brunogle/fuente-12v/3d_top.png

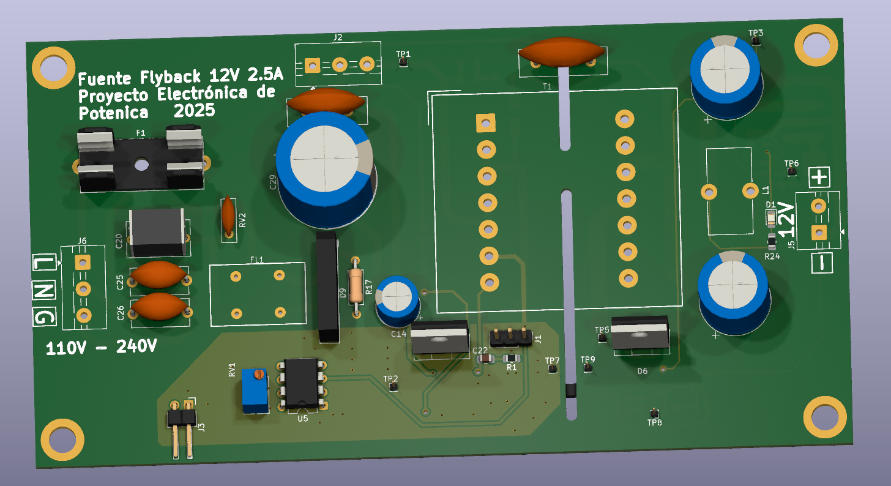
3d_top.png
