brunogle/fuente-12v/3d_bottom.png

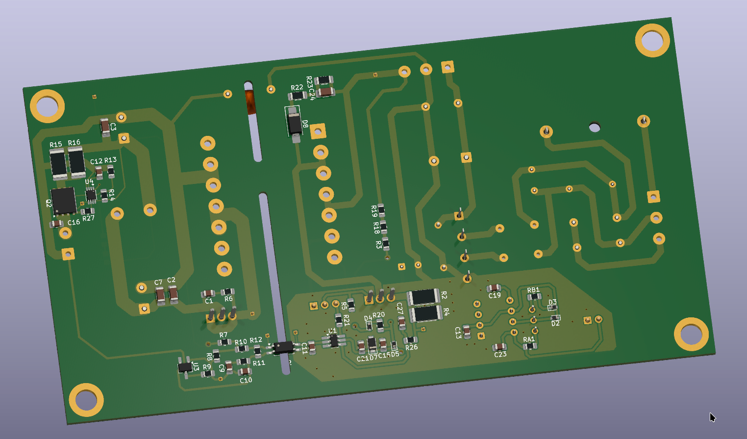
3d_bottom.png
