brunogle/fuente-12v/bottom.png

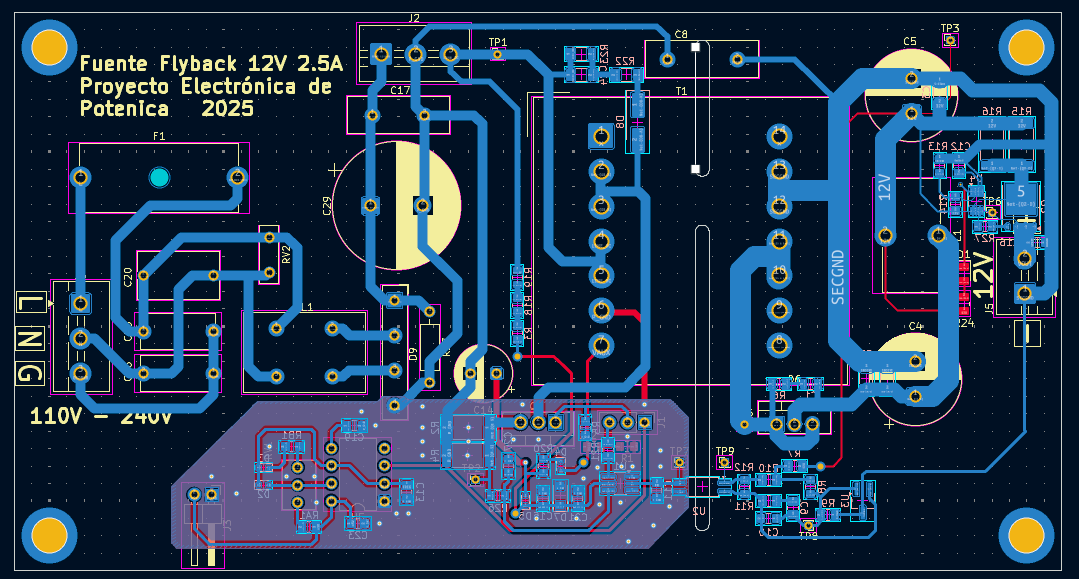
bottom.png
