brunogle/fuente-12v/fuente-12v.csv

Reference | Qty | Value | DNP | Exclude from BOM | Exclude from Board | Footprint | Datasheet | Description
C1,C9 | 2 | 680pF |  |  |  | Capacitor_SMD:C_0805_2012Metric_Pad1.18x1.45mm_HandSolder | ~
C2,C3,C7 | 3 | 4.7uF |  |  |  | Capacitor_SMD:C_1206_3216Metric_Pad1.33x1.80mm_HandSolder | ~
C4,C5 | 2 | 470u |  |  |  | Capacitor_THT:CP_Radial_D13.0mm_P5.00mm | ~ | FALTA DECIDIR
C8 | 1 | 1nF Y1 |  |  |  | Capacitor_THT:C_Disc_D16.0mm_W5.0mm_P10.00mm | ~ | https://www.mercadolibre.com.ar/x10-capacitor-ceramico-disco-supresor-1000pf-0001uf-x1-y1/up/MLAU278369151
C10 | 1 | 56pF |  |  |  | Capacitor_SMD:C_0805_2012Metric_Pad1.18x1.45mm_HandSolder | ~
C11 | 1 | 1nF |  |  |  | Capacitor_SMD:C_0805_2012Metric_Pad1.18x1.45mm_HandSolder | ~
C12 | 1 | 56nF |  |  |  | Capacitor_SMD:C_0805_2012Metric_Pad1.18x1.45mm_HandSolder | ~
C13,C19 | 2 | 10n |  |  |  | Capacitor_SMD:C_0805_2012Metric_Pad1.18x1.45mm_HandSolder | ~
C14 | 1 | 100uF |  |  |  | Capacitor_THT:CP_Radial_D8.0mm_P3.80mm | ~ | https://www.mercadolibre.com.ar/10-capacitores-electroliticos-100uf-x-35v-105-8x12mm/up/MLAU127441689
C15 | 1 | 4.7uF 50V |  |  |  | Capacitor_SMD:C_0805_2012Metric_Pad1.18x1.45mm_HandSolder | ~
C16 | 1 | 470nF |  |  |  | Capacitor_SMD:C_0805_2012Metric_Pad1.18x1.45mm_HandSolder | ~
C17 | 1 | 470nF 400V |  |  |  | Capacitor_THT:C_Disc_D14.5mm_W5.0mm_P7.50mm | ~
C20 | 1 | 33nF X2 |  |  |  | Capacitor_THT:C_Rect_L11.5mm_W6.6mm_P10.00mm_MKT | ~ | Bruno tiene
C21,C23 | 2 | 100nF |  |  |  | Capacitor_SMD:C_0805_2012Metric_Pad1.18x1.45mm_HandSolder | ~
C22 | 1 | 470pF |  |  |  | Capacitor_SMD:C_0805_2012Metric_Pad1.18x1.45mm_HandSolder | ~
C24 | 1 | 10nF |  |  |  | Capacitor_SMD:C_1206_3216Metric_Pad1.33x1.80mm_HandSolder | ~
C25,C26 | 2 | 1nF Y1 |  |  |  | Capacitor_THT:C_Disc_D10.5mm_W5.0mm_P10.00mm | ~ | https://www.mercadolibre.com.ar/x10-capacitor-ceramico-disco-supresor-1000pf-0001uf-x1-y1/up/MLAU278369151
C27 | 1 | 22pF 50V |  |  |  | Capacitor_SMD:C_0805_2012Metric_Pad1.18x1.45mm_HandSolder | ~
C29 | 1 | 150uF 400V |  |  |  | Capacitor_THT:CP_Radial_D18.0mm_P7.50mm | ~ | Bruno tiene uno solo
D2,D3,D4,D5 | 4 | 1N4148WT |  |  |  | Diode_SMD:D_SOD-523 | https://www.diodes.com/assets/Datasheets/ds30396.pdf | https://www.mercadolibre.com.ar/x10-1n4148ws-sod323-1n4148-ws-w2-smd-diodo/up/MLAU3429642478
D6 | 1 | MBR20200CT |  |  |  | Package_TO_SOT_THT:TO-220-3_Vertical | ~ | https://www.mercadolibre.com.ar/diodo-mbr20200ct-mbr20200-schottky-doble-20a-200v-to220/up/MLAU263325914
D7 | 1 | Bzt52c20 |  |  |  | Diode_SMD:Nexperia_CFP3_SOD-123W | ~ | https://www.mercadolibre.com.ar/bzt52c20-bzt-52c20-wm-diodo-zener-20-v-05w-sod-123-x-5-unid/p/MLA2042479519
D8 | 1 | ES1J |  |  |  | Diode_SMD:D_SMA_Handsoldering | ~ | https://www.mercadolibre.com.ar/kit-x50-es1j-diodo-fast-rapido-smd-1a-600v-35ns-uf4007/p/MLA2042186244
D9 | 1 | KBL10 |  |  |  | Diode_THT:Diode_Bridge_19.0x3.5x10.0mm_P5.0mm | ~ | https://www.sycelectronica.com.ar/articulo.php?codigo=KBL10
F1 | 1 | 1A 20mm |  |  |  | Fuse:Fuseholder_Cylinder-5x20mm_Schurter_0031_8201_Horizontal_Open | ~ | https://www.sycelectronica.com.ar/pasivos/PF-CUNA-20.pdf
FL1 | 1 | ST-110BH |  |  |  | fuente-12v:ST-110 | ~ | https://www.microelectronicash.com/filtro-linea--det--FILTRO-LINEA
J1 | 1 | Conn_01x03_Pin |  |  |  | Connector_PinHeader_2.54mm:PinHeader_1x03_P2.54mm_Vertical | ~
J2 | 1 | Screw_Terminal_01x03 |  |  |  | TerminalBlock:TerminalBlock_MaiXu_MX126-5.0-03P_1x03_P5.00mm | ~ | Screw_Terminal_01x03 P5mm
J3 | 1 | Conn_01x02_Pin |  |  |  | Connector_PinHeader_2.54mm:PinHeader_1x02_P2.54mm_Horizontal | ~
J5 | 1 | OUTPUT |  |  |  | TerminalBlock:TerminalBlock_MaiXu_MX126-5.0-02P_1x02_P5.00mm | ~ | Screw_Terminal_01x02 P5mm
J6 | 1 | Screw_Terminal_01x03 P5mm |  |  |  | TerminalBlock:TerminalBlock_MaiXu_MX126-5.0-03P_1x03_P5.00mm | ~ | Screw_Terminal_01x03 P5mm
L1 | 1 | 10uH 3A |  |  |  | Inductor_THT:L_Toroid_Vertical_L16.0mm_W8.0mm_P7.62mm | ~ | FALTA DECIDIR
Q1 | 1 | IPP65R190C7 |  |  |  | Package_TO_SOT_THT:TO-220-3_Vertical | ~ | Tenemos
Q2 | 1 | CSD16403Q5A |  |  |  | Package_TO_SOT_SMD:TDSON-8-1 | http://www.ti.com/lit/gpn/csd16403q5a | Tenemos
R1,R20,R21,R27 | 4 | 10 |  |  |  | Resistor_SMD:R_0805_2012Metric_Pad1.20x1.40mm_HandSolder | ~
R2,R4 | 2 | 0.47 |  |  |  | Resistor_SMD:R_2512_6332Metric_Pad1.40x3.35mm_HandSolder | ~ | https://www.dicomse.com.ar/
R3,R18,R19 | 3 | 2M |  |  |  | Resistor_SMD:R_0805_2012Metric_Pad1.20x1.40mm_HandSolder | ~
R5,R14,R26 | 3 | 10k |  |  |  | Resistor_SMD:R_0805_2012Metric_Pad1.20x1.40mm_HandSolder | ~
R6 | 1 | 100 |  |  |  | Resistor_SMD:R_0805_2012Metric_Pad1.20x1.40mm_HandSolder | ~
R7 | 1 | 51 |  |  |  | Resistor_SMD:R_0805_2012Metric_Pad1.20x1.40mm_HandSolder | ~
R8 | 1 | 86.6k |  |  |  | Resistor_SMD:R_0805_2012Metric_Pad1.20x1.40mm_HandSolder | ~
R9 | 1 | 23.4k |  |  |  | Resistor_SMD:R_0805_2012Metric_Pad1.20x1.40mm_HandSolder | ~
R10 | 1 | 5k |  |  |  | Resistor_SMD:R_0805_2012Metric_Pad1.20x1.40mm_HandSolder | ~ | Resistor
R11 | 1 | 133k |  |  |  | Resistor_SMD:R_0805_2012Metric_Pad1.20x1.40mm_HandSolder | ~
R12 | 1 | 2.49k |  |  |  | Resistor_SMD:R_0805_2012Metric_Pad1.20x1.40mm_HandSolder | ~
R13 | 1 | 120k |  |  |  | Resistor_SMD:R_0805_2012Metric_Pad1.20x1.40mm_HandSolder | ~
R15,R16 | 2 | 1 |  |  |  | Resistor_SMD:R_2512_6332Metric_Pad1.40x3.35mm_HandSolder | ~ | https://www.dicomse.com.ar/
R17 | 1 | 1M |  |  |  | Resistor_THT:R_Axial_DIN0207_L6.3mm_D2.5mm_P10.16mm_Horizontal | ~
R22 | 1 | 22 |  |  |  | Resistor_SMD:R_1206_3216Metric_Pad1.30x1.75mm_HandSolder | ~
R23 | 1 | 80k |  |  |  | Resistor_SMD:R_1206_3216Metric_Pad1.30x1.75mm_HandSolder | ~
RA1,RB1 | 2 | 220 |  |  |  | Resistor_SMD:R_0805_2012Metric_Pad1.20x1.40mm_HandSolder | ~
RV1 | 1 | 1k |  |  |  | Potentiometer_THT:Potentiometer_Bourns_3266Y_Vertical | ~
RV2 | 1 | Varistor |  |  |  | Capacitor_THT:C_Disc_D8.0mm_W2.5mm_P5.00mm | ~ | Bruno tiene
T1 | 1 | ~ |  |  |  | fuente-12v:750811744 | https://www.we-online.com/components/products/datasheet/750811744.pdf | Tenemos
TP1,TP2,TP3,TP5,TP6,TP7,TP8,TP9 | 8 | TestPoint |  |  |  | Connector_PinHeader_1.00mm:PinHeader_1x01_P1.00mm_Vertical | ~ | test point
U1 | 1 | UCC287501D |  |  |  | Package_TO_SOT_SMD:TSOT-23-6_HandSoldering | https://www.ti.com/lit/ds/symlink/ucc28750.pdf | Tenemos
U2 | 1 | TCMT1107 |  |  |  | Package_SO:SOP-4_4.4x2.6mm_P1.27mm | http://www.vishay.com/docs/83510/tcmt1100.pdf | Tenemos
U3 | 1 | TL432DBZ |  |  |  | Package_TO_SOT_SMD:SOT-23W_Handsoldering | http://www.ti.com/lit/ds/symlink/tl431.pdf | Tenemos
U4 | 1 | TPS24701DGKR |  |  |  | Package_SO:VSSOP-8_2.3x2mm_P0.5mm | https://www.ti.com/lit/ds/symlink/ucc28750.pdf | Tenemos
U5 | 1 | NE555P |  |  |  | Package_DIP:DIP-8_W7.62mm | http://www.ti.com/lit/ds/symlink/ne555.pdf
