brunogle/fuente-12v/fuente-12v-schematics.pdf

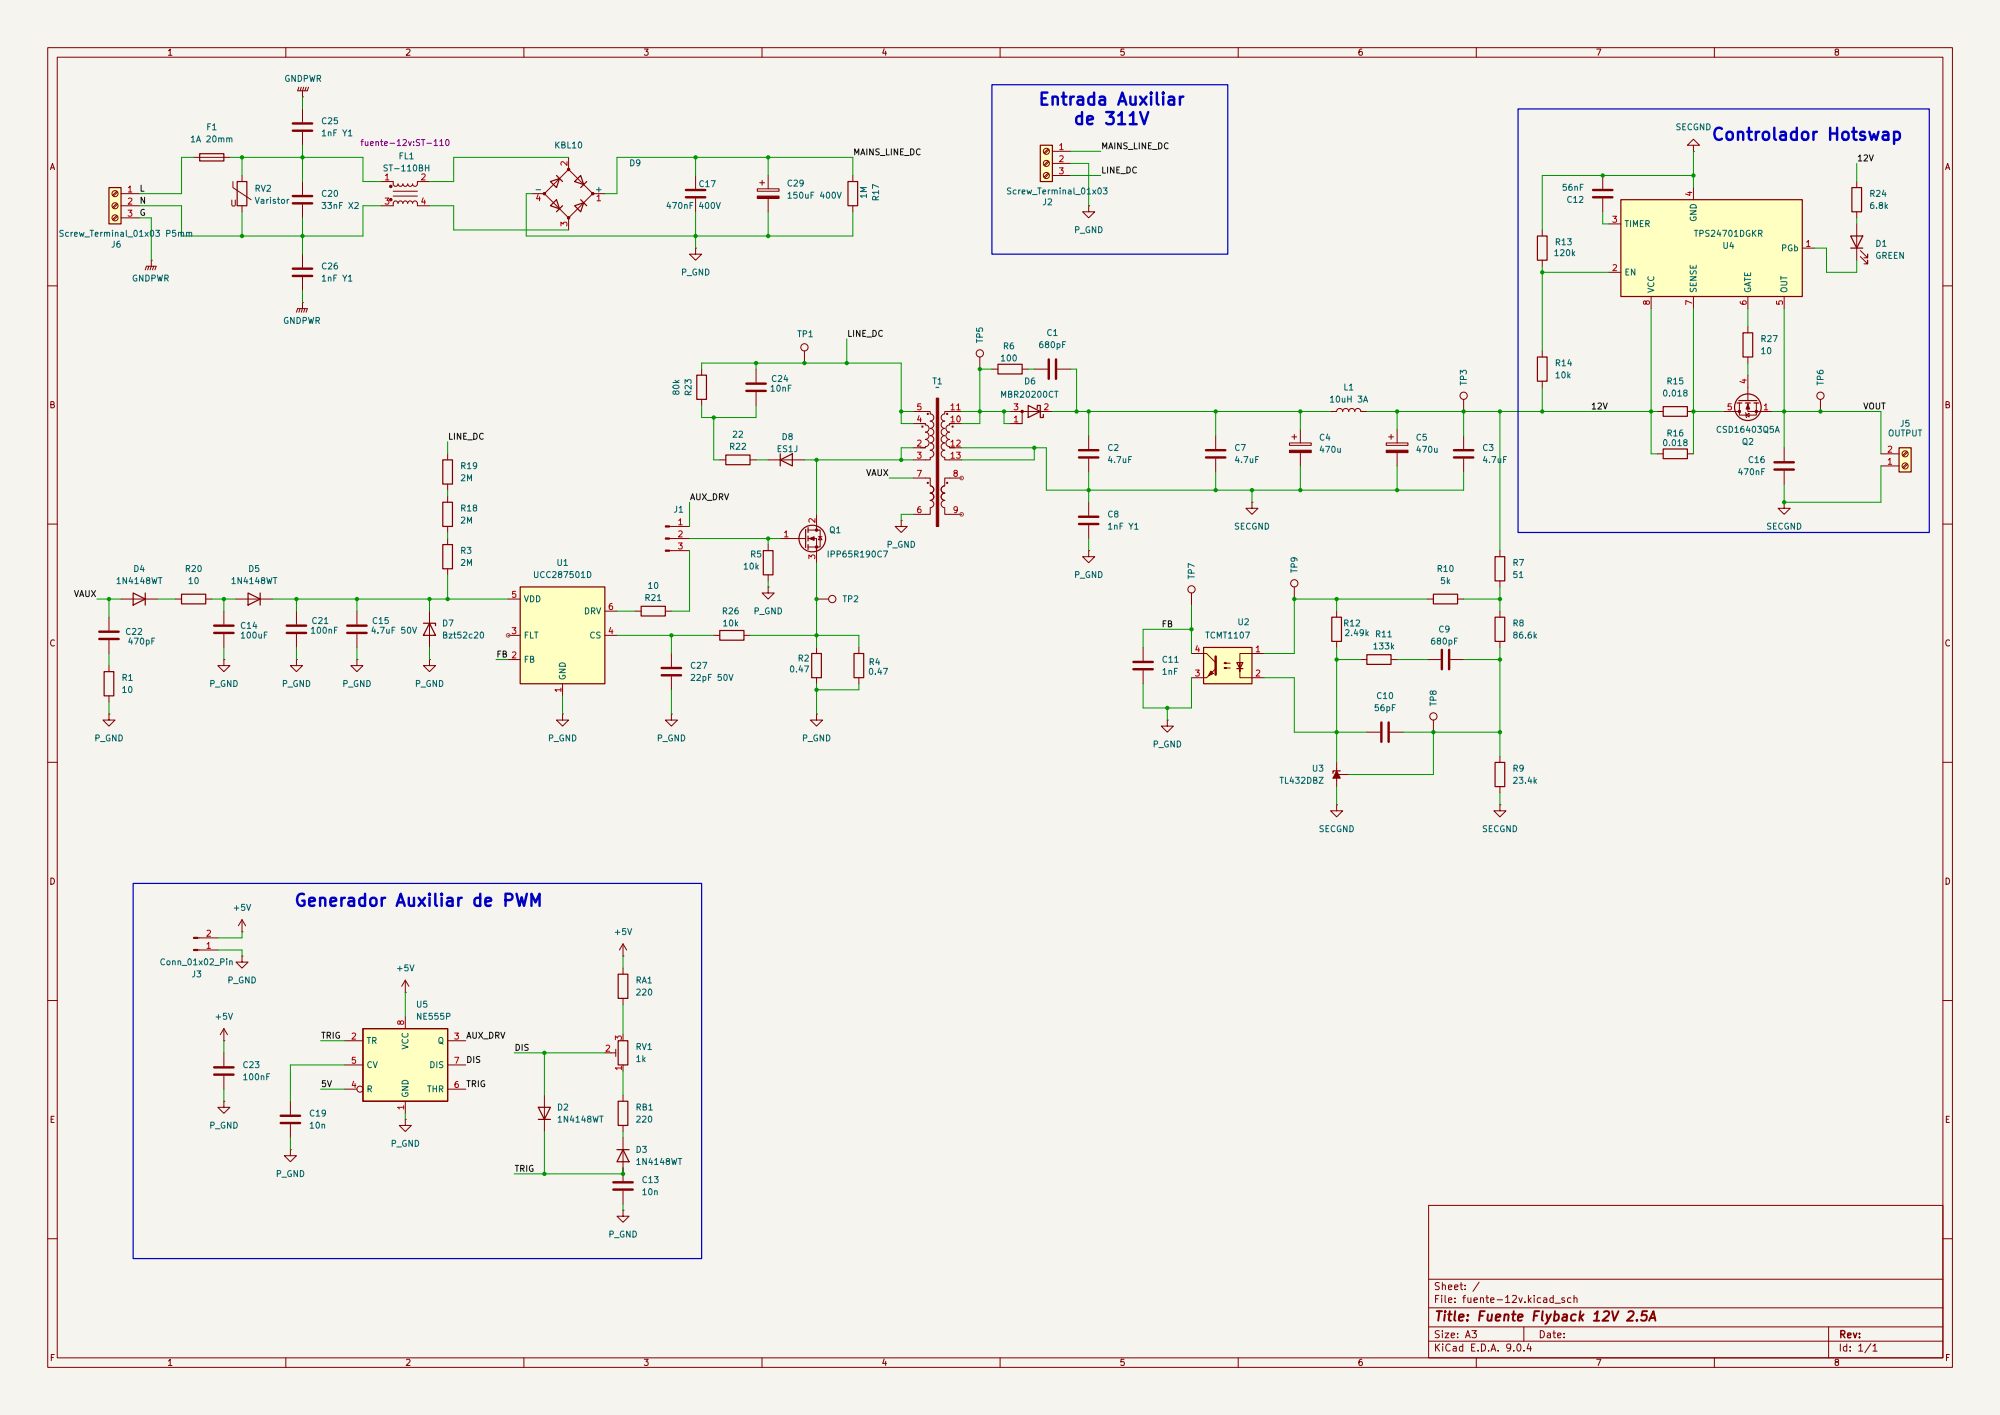
[picture p4: page 1]
