brunogle/fuente-12v/fuente-12v.kicad_pcb

## KiCad design fuente-12v.kicad_pcb (2025-10-09)

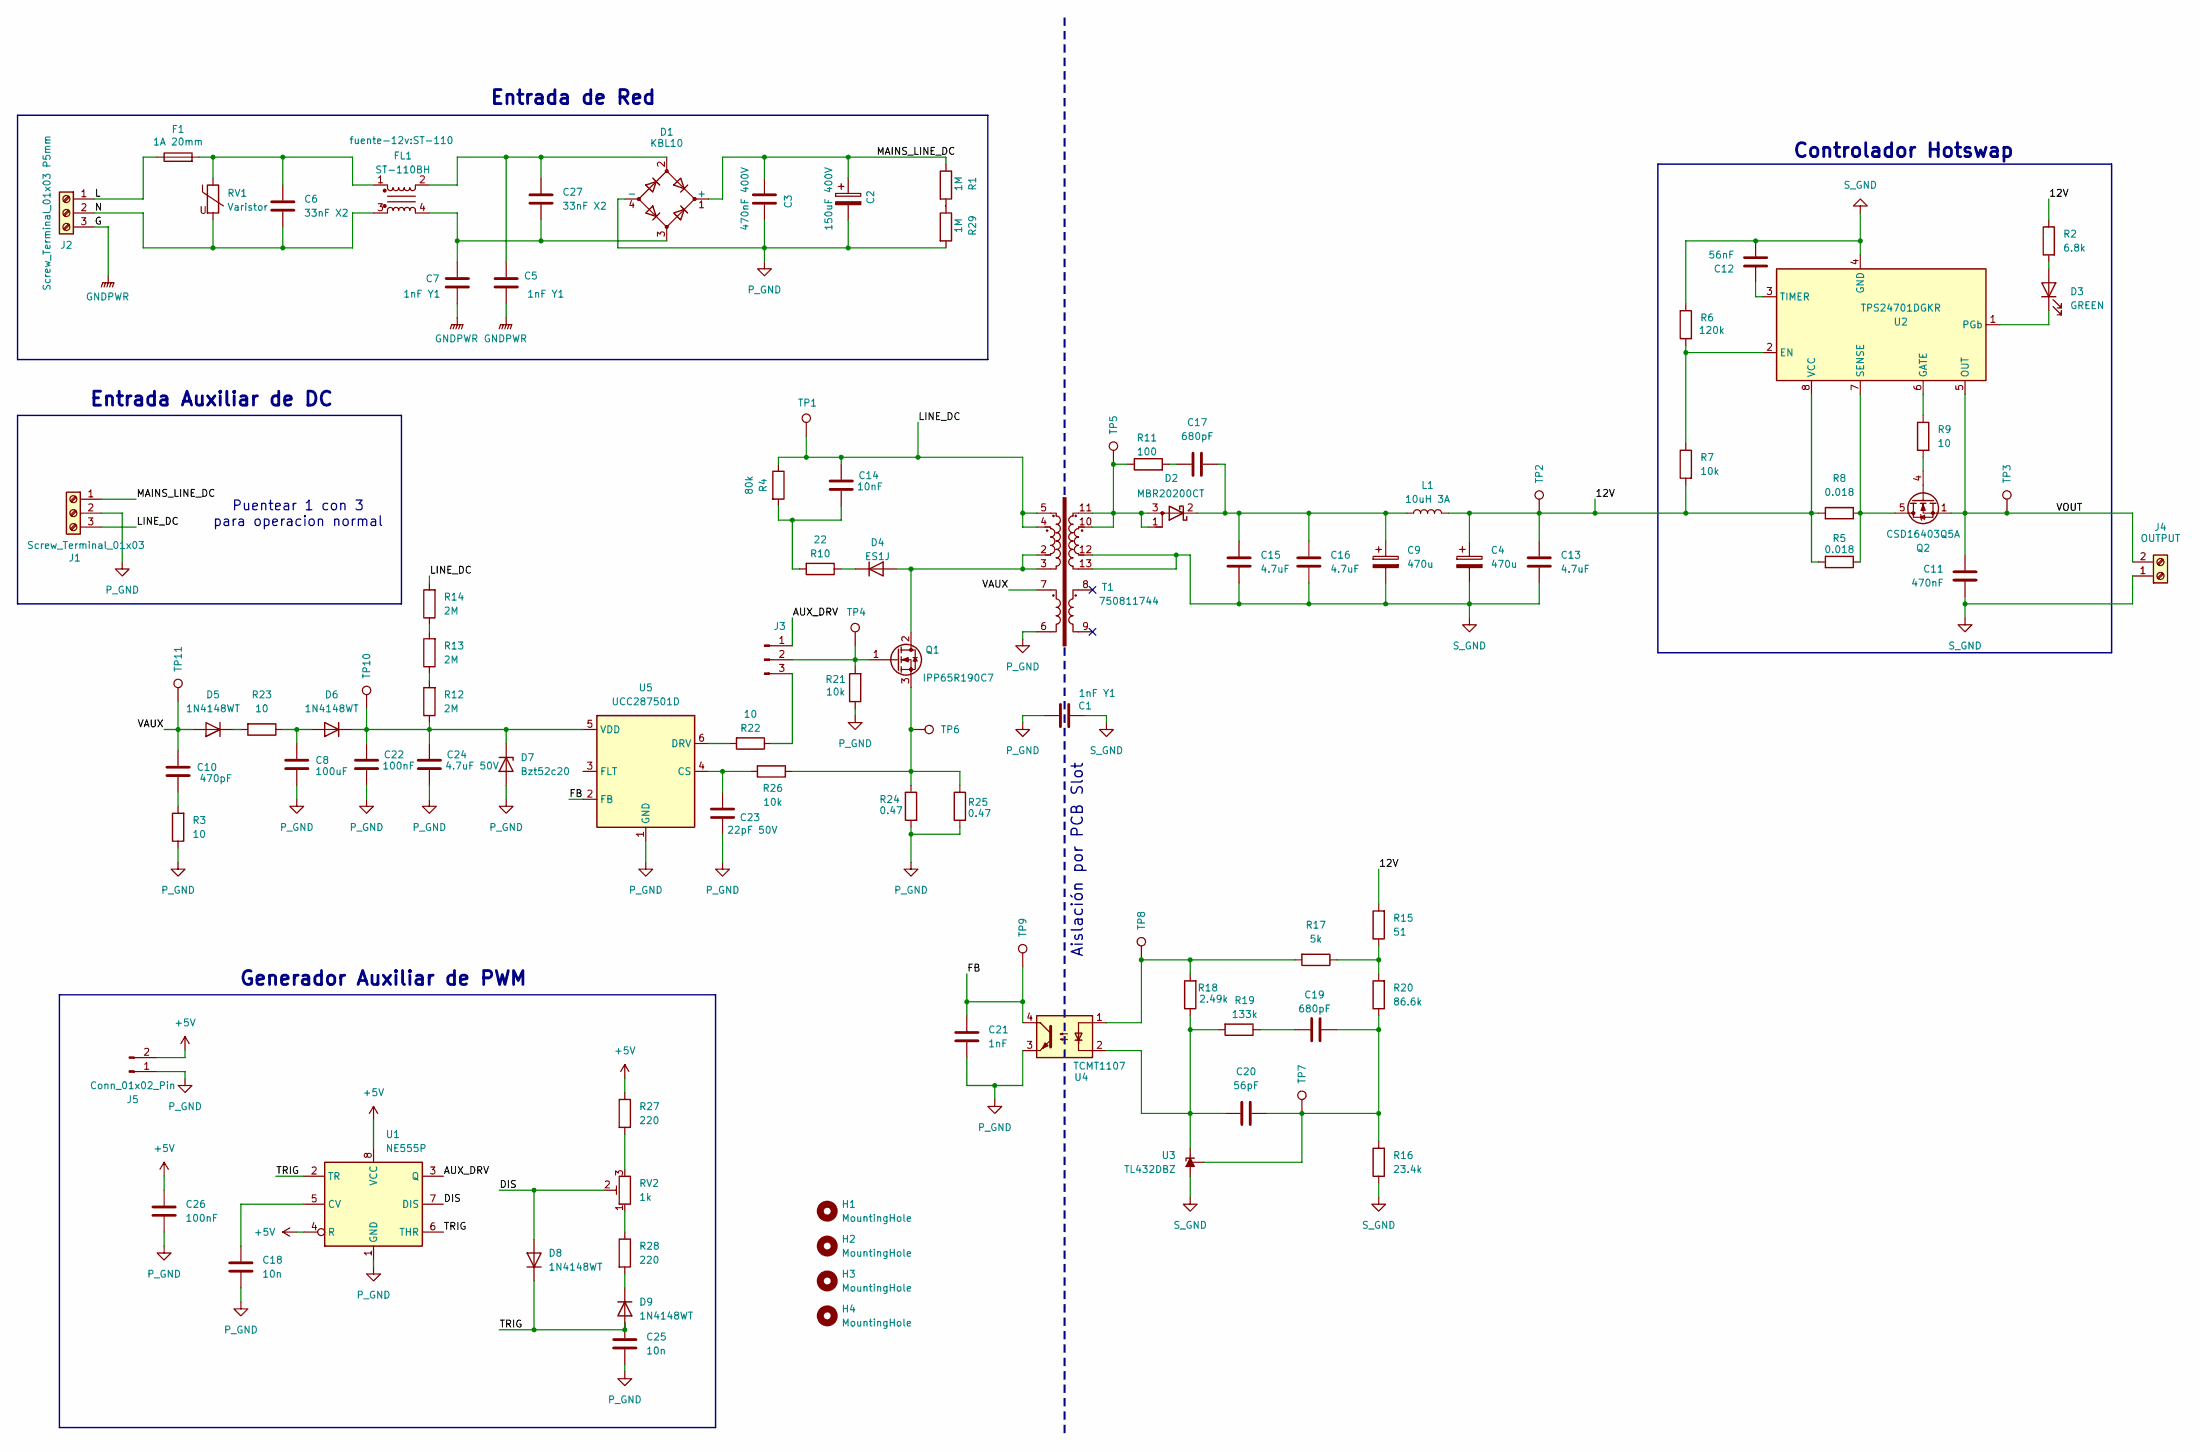
[picture p5: schematic fuente-12v.kicad_sch, Fuente Flyback 12V 2.5A]

Parts:
C1: 1nF Y1; C_Disc_D16.0mm_W5.0mm_P10.00mm
C2: 150uF 400V; CP_Radial_D18.0mm_P7.50mm
C3: 470nF 400V; C_Disc_D14.5mm_W5.0mm_P7.50mm
C4, C9: 470u; CP_Radial_D13.0mm_P5.00mm
C5, C7: 1nF Y1; C_Disc_D10.5mm_W5.0mm_P10.00mm
C6, C27: 33nF X2; C_Rect_L11.5mm_W6.6mm_P10.00mm_MKT
C8: 100uF; CP_Radial_D8.0mm_P3.80mm
C10: 470pF; C_0805_2012Metric_Pad1.18x1.45mm_HandSolder
C11: 470nF; C_0805_2012Metric_Pad1.18x1.45mm_HandSolder
C12: 56nF; C_0805_2012Metric_Pad1.18x1.45mm_HandSolder
C13, C15, C16: 4.7uF; C_1206_3216Metric_Pad1.33x1.80mm_HandSolder
C14: 10nF; C_1206_3216Metric_Pad1.33x1.80mm_HandSolder
C17, C19: 680pF; C_0805_2012Metric_Pad1.18x1.45mm_HandSolder
C18, C25: 10n; C_0805_2012Metric_Pad1.18x1.45mm_HandSolder
C20: 56pF; C_0805_2012Metric_Pad1.18x1.45mm_HandSolder
C21: 1nF; C_0805_2012Metric_Pad1.18x1.45mm_HandSolder
C22, C26: 100nF; C_0805_2012Metric_Pad1.18x1.45mm_HandSolder
C23: 22pF 50V; C_0805_2012Metric_Pad1.18x1.45mm_HandSolder
C24: 4.7uF 50V; C_0805_2012Metric_Pad1.18x1.45mm_HandSolder
D1: KBL10; Diode_Bridge_19.0x3.5x10.0mm_P5.0mm
D2: MBR20200CT; TO-220-3_Vertical
D3: GREEN; LED_0805_2012Metric_Pad1.15x1.40mm_HandSolder
D4: ES1J; D_SMA_Handsoldering
D5, D6, D8, D9: 1N4148WT; D_SOD-523
D7: Bzt52c20; Nexperia_CFP3_SOD-123W
F1: 1A 20mm; Fuseholder_BLX-A
FL1: ST-110BH; ST-110
H1, H2, H3, H4: MountingHole; MountingHole_4.3mm_M4_DIN965
J1: Screw_Terminal_01x03; TerminalBlock_MaiXu_MX126-5.0-03P_1x03_P5.00mm
J2: Screw_Terminal_01x03 P5mm; TerminalBlock_MaiXu_MX126-5.0-03P_1x03_P5.00mm
J3: Conn_01x03_Pin; PinHeader_1x03_P2.54mm_Vertical
J4: OUTPUT; TerminalBlock_MaiXu_MX126-5.0-02P_1x02_P5.00mm
J5: Conn_01x02_Pin; PinHeader_1x02_P2.54mm_Horizontal
L1: 10uH 3A; L_Toroid_Vertical_L16.0mm_W8.0mm_P7.62mm
Q1: IPP65R190C7; TO-220-3_Vertical
Q2: CSD16403Q5A; TDSON-8-1
R1, R29: 1M; R_1206_3216Metric_Pad1.30x1.75mm_HandSolder
R2: 6.8k; R_0805_2012Metric_Pad1.20x1.40mm_HandSolder
R3, R9, R22, R23: 10; R_0805_2012Metric_Pad1.20x1.40mm_HandSolder
R4: 80k; R_1206_3216Metric_Pad1.30x1.75mm_HandSolder
R5, R8: 0.018; R_2512_6332Metric_Pad1.40x3.35mm_HandSolder
R6: 120k; R_0805_2012Metric_Pad1.20x1.40mm_HandSolder
R7, R21, R26: 10k; R_0805_2012Metric_Pad1.20x1.40mm_HandSolder
R10: 22; R_1206_3216Metric_Pad1.30x1.75mm_HandSolder
R11: 100; R_0805_2012Metric_Pad1.20x1.40mm_HandSolder
R12, R13, R14: 2M; R_0805_2012Metric_Pad1.20x1.40mm_HandSolder
R15: 51; R_0805_2012Metric_Pad1.20x1.40mm_HandSolder
R16: 23.4k; R_0805_2012Metric_Pad1.20x1.40mm_HandSolder
R17: 5k; R_0805_2012Metric_Pad1.20x1.40mm_HandSolder
R18: 2.49k; R_0805_2012Metric_Pad1.20x1.40mm_HandSolder
R19: 133k; R_0805_2012Metric_Pad1.20x1.40mm_HandSolder
R20: 86.6k; R_0805_2012Metric_Pad1.20x1.40mm_HandSolder
R24, R25: 0.47; R_2512_6332Metric_Pad1.40x3.35mm_HandSolder
R27, R28: 220; R_0805_2012Metric_Pad1.20x1.40mm_HandSolder
RV1: Varistor; C_Disc_D8.0mm_W2.5mm_P5.00mm
RV2: 1k; Potentiometer_Bourns_3266Y_Vertical
T1: 750811744
TP1, TP2, TP3, TP4, TP5, TP6, TP7, TP8, TP9, TP10, TP11: TestPoint; PinHeader_1x01_P1.00mm_Vertical
U1: NE555P; DIP-8_W7.62mm
U2: TPS24701DGKR; VSSOP-8_2.3x2mm_P0.5mm
U3: TL432DBZ; SOT-23W_Handsoldering
U4: TCMT1107; SOP-4_4.4x2.6mm_P1.27mm
U5: UCC287501D; TSOT-23-6_HandSoldering

Connections:
+5V: C26.1, J5.2, R27.1, U1.4 (R), U1.8 (VCC)
/12V: C4.1, C13.2, L1.2, R2.1, R5.2, R7.2, R8.2, R15.2, TP2.1, U2.8 (VCC)
/AUX_DRV: J3.1, U1.3 (Q)
/DIS: D8.2 (A), RV2.2, U1.7 (DIS)
/FB: C21.2, TP9.1, U4.4, U5.2 (FB)
/L: F1.1, J2.1
/LINE_DC: C14.1, J1.3, R4.1, R14.2, T1.4, T1.5, TP1.1
/MAINS_LINE_DC: C2.1, C3.1, D1.1 (+), J1.1, R1.1
/N: C6.1, FL1.3, J2.2, RV1.2
/TRIG: C25.1, D8.1 (K), D9.2 (A), U1.2 (TR), U1.6 (THR)
/VAUX: C10.1, D5.2 (A), T1.7, TP11.1
/VOUT: C11.2, J4.2, Q2.1 (S), Q2.2 (S), Q2.3 (S), TP3.1, U2.5 (OUT)
GNDPWR: C5.2, C7.1, J2.3
unnamed: C6.2, F1.2, FL1.1, RV1.1
unnamed: C10.2, R3.2
unnamed: C14.2, R4.2, R10.2
unnamed: C17.1, R11.2
unnamed: C19.2, R19.1
unnamed: C7.2, C27.1, D1.3, FL1.4
unnamed: C5.1, C27.2, D1.2, FL1.2
unnamed: D2.1 (A), D2.3 (A), R11.1, T1.10, T1.11, TP5.1
unnamed: C9.1, C15.2, C16.2, C17.2, D2.2 (K), L1.1
unnamed: D3.2 (A), R2.2
unnamed: D3.1 (K), U2.1 (PGb)
unnamed: D4.2 (A), Q1.2 (D), T1.2, T1.3
unnamed: D4.1 (K), R10.1
unnamed: D5.1 (K), R23.2
unnamed: C8.1, D6.2 (A), R23.1
unnamed: C22.1, C24.1, D6.1 (K), D7.1 (K), R12.1, TP10.1, U5.5 (VDD)
unnamed: D9.1 (K), R28.2
unnamed: J3.2, Q1.1 (G), R21.2, TP4.1
unnamed: J3.3, R22.1
unnamed: Q1.3 (S), R24.1, R25.1, R26.1, TP6.1
unnamed: Q2.5 (D), R5.1, R8.1, U2.7 (SENSE)
unnamed: Q2.4 (G), R9.2
unnamed: R1.2, R29.1
unnamed: R12.2, R13.1
unnamed: R13.2, R14.1
unnamed: R15.1, R17.1, R20.2
unnamed: R17.2, R18.2, TP8.1, U4.1
unnamed: R27.2, RV2.3
unnamed: R28.1, RV2.1
unnamed: C18.1, U1.5 (CV)
unnamed: R6.2, R7.1, U2.2 (EN)
unnamed: R9.1, U2.6 (GATE)
unnamed: C12.2, U2.3 (TIMER)
unnamed: C20.2, R18.1, R19.2, U3.2 (K), U4.2
unnamed: C19.1, C20.1, R16.2, R20.1, TP7.1, U3.1 (REF)
unnamed: C23.2, R26.2, U5.4 (CS)
unnamed: R22.2, U5.6 (DRV)
P_GND: C1.2, C2.2, C3.2, C8.2, C18.2, C21.1, C22.2, C23.1, C24.2, C25.2, C26.2, D1.4 (-), D7.2 (A), J1.2, J5.1, R3.1, R21.1, R24.2, R25.2, R29.2, T1.6, U1.1 (GND), U4.3, U5.1 (GND)
S_GND: C1.1, C4.2, C9.2, C11.1, C12.1, C13.1, C15.1, C16.1, J4.1, R6.1, R16.1, T1.12, T1.13, U2.4 (GND), U3.3 (A)

Notes on the sheet:
Aislación por PCB Slot
Puentear 1 con 3 para operacion normal
Entrada de Red
Controlador Hotswap
Entrada Auxiliar de DC
Generador Auxiliar de PWM

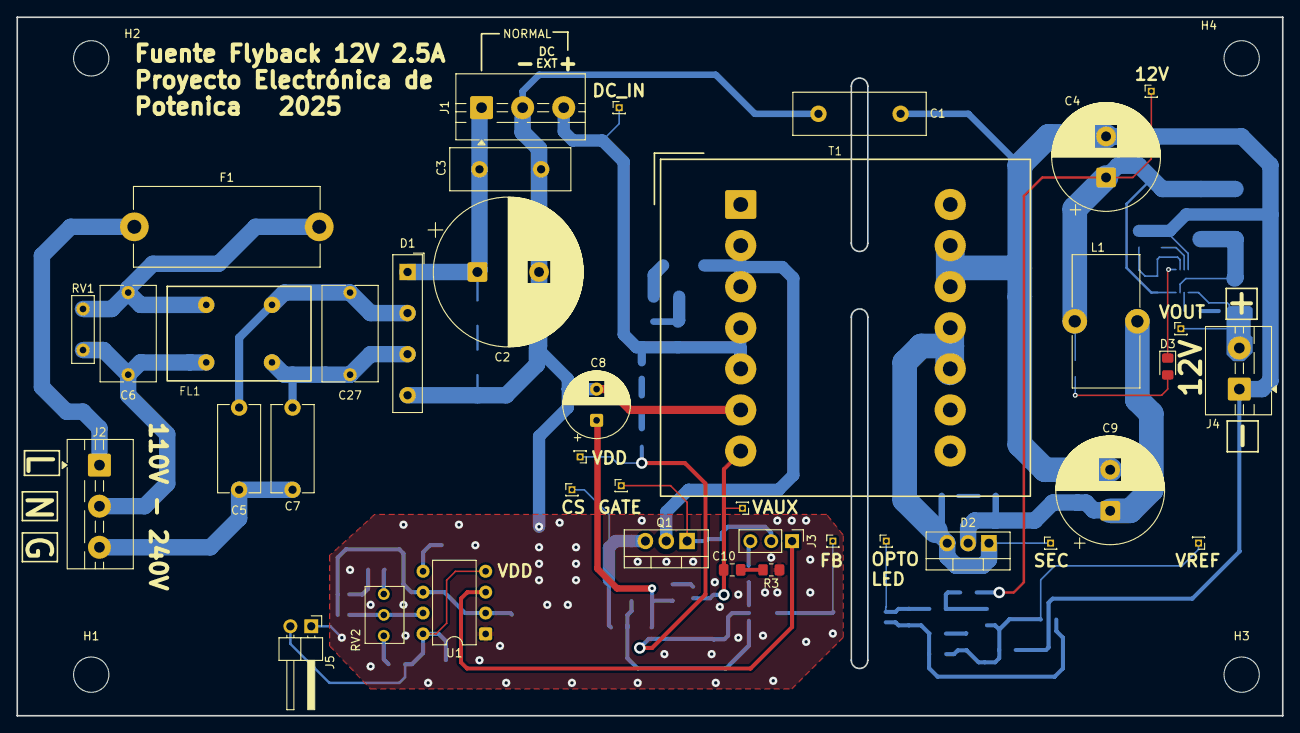
[picture p6: board fuente-12v.kicad_pcb from above]

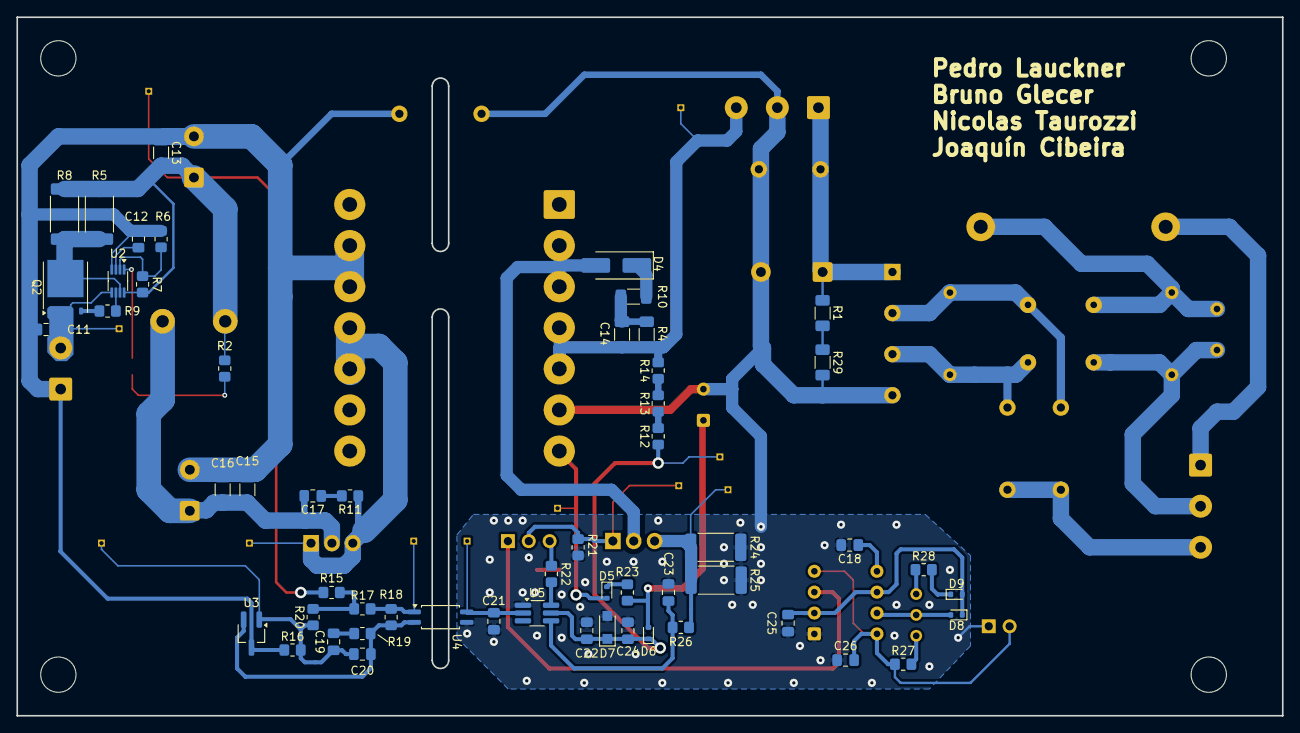
[picture p7: board fuente-12v.kicad_pcb from below]

Board: 2 copper layers, 154.0 x 85.0 mm, 98 parts (55 on the bottom side), 52 nets.
