brunogle/fuente-12v/(commit log)

2025-08-25 Started schematic
    [fuente-12v.kicad_pcb, fuente-12v.kicad_sch]
2025-10-06 Esquematico completo y PCB routeado
    [fuente-12v.csv, fuente-12v.kicad_pcb, fuente-12v.kicad_sch]
2025-10-09 Terminada. Necesita revision
    [bom.csv, designators.csv, fuente-12v.kicad_pcb, fuente-12v.kicad_sch, positions.csv]
2025-10-09 Version enviada a JLCPCB
    [bom.csv, designators.csv, fuente-12v.kicad_pcb, fuente-12v.kicad_sch, positions.csv]
